Sergey-V-Z/Ethernet_Power_Load_Controller/Documentations/DG1_LEG.jpg

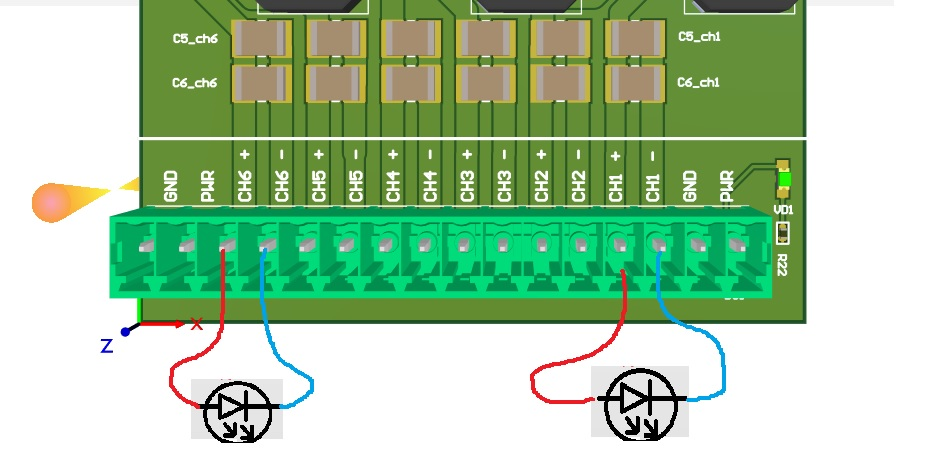
Documentations/DG1_LEG.jpg
