Sergey-V-Z/Ethernet_Power_Load_Controller/PCB/control_PWR_PCB/control_PWR_PCB.pdf

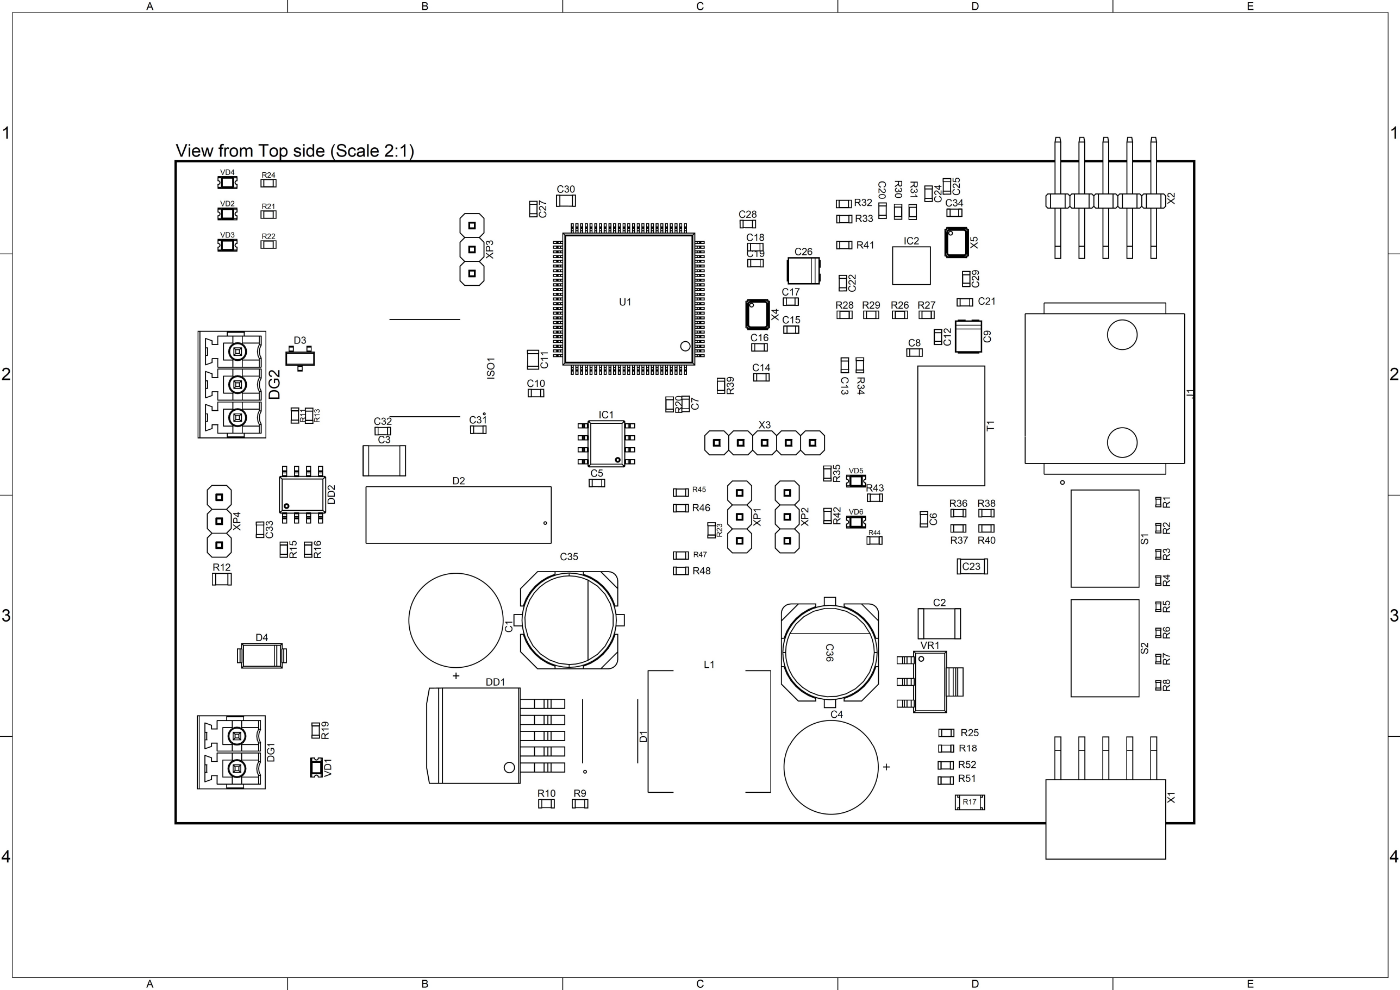
[picture p8: page 1]
