Sergey-V-Z/Ethernet_Power_Load_Controller/PCB/driverPCB/asembl.pdf

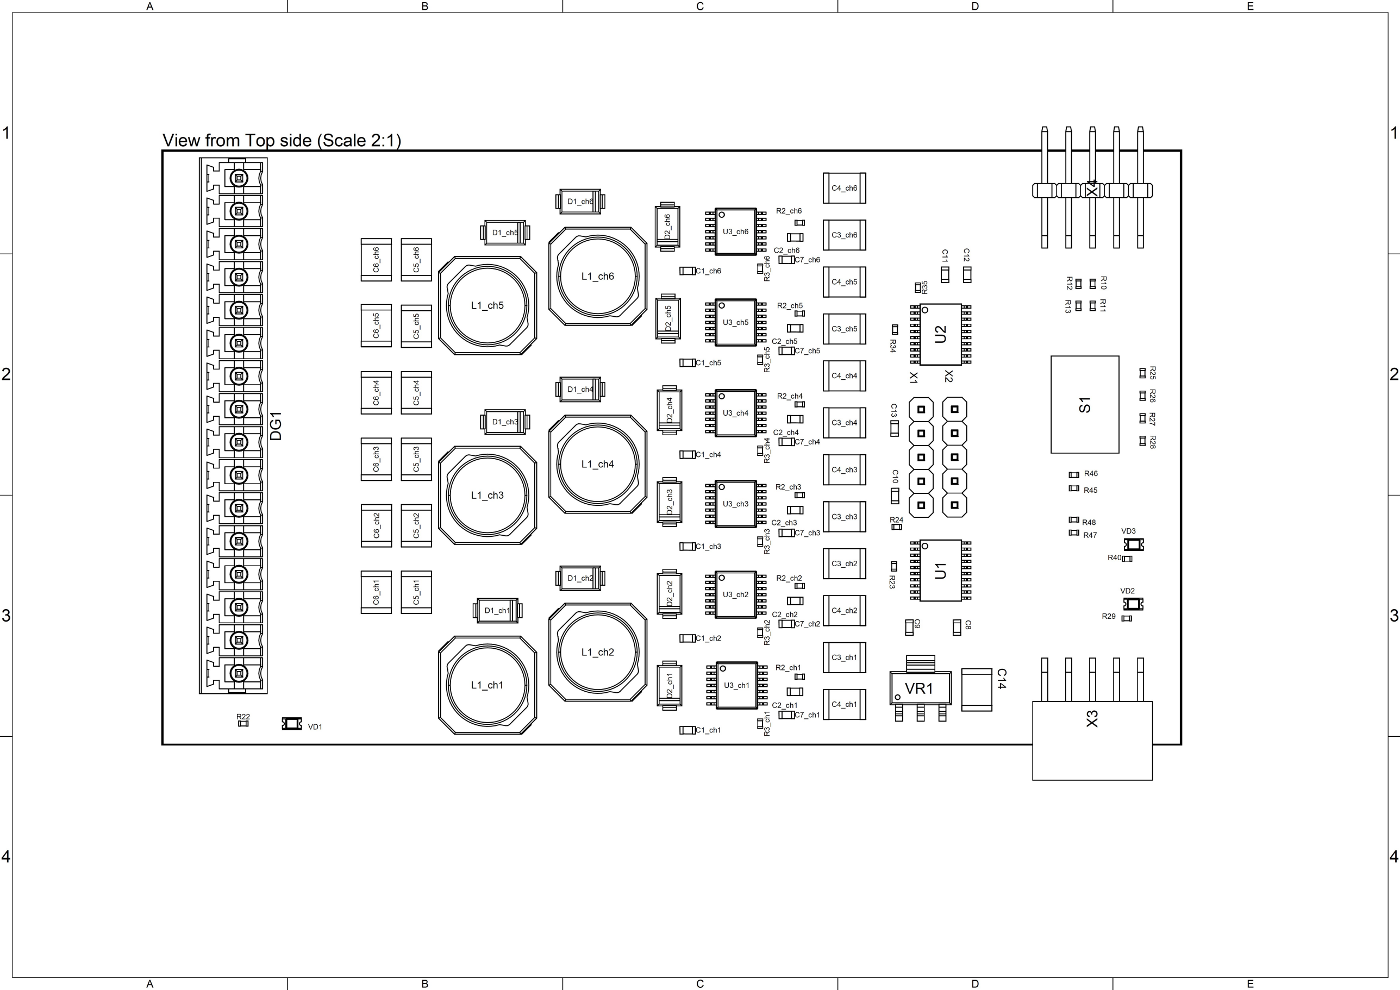
[picture p9: page 1]
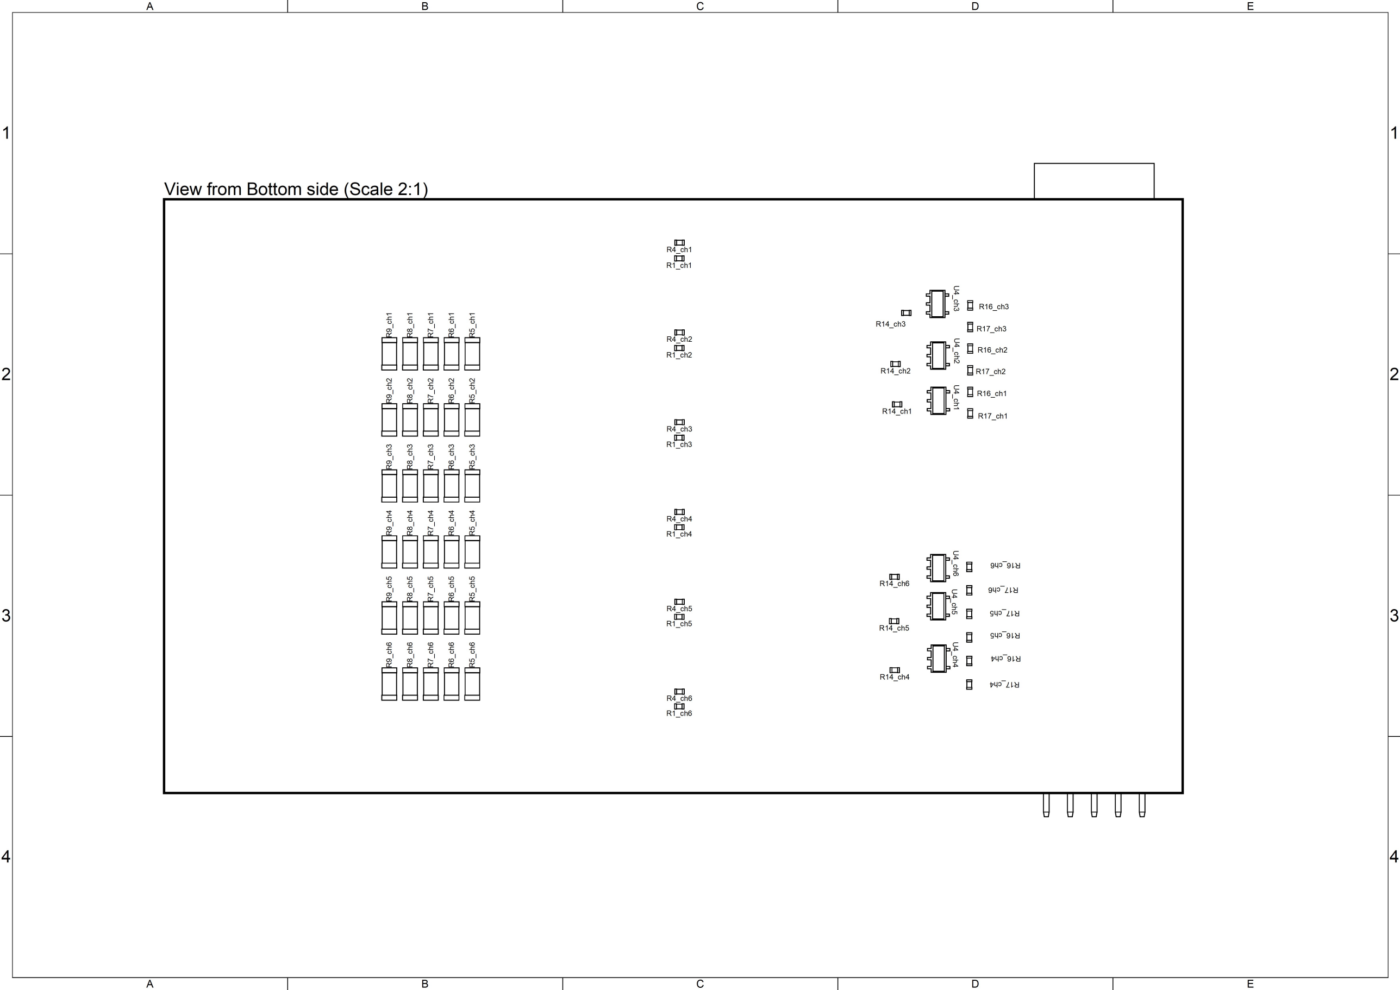
[picture p10: page 2]
