Sergey-V-Z/Ethernet_Power_Load_Controller/Documentations/Adres_Driver_LED.jpg

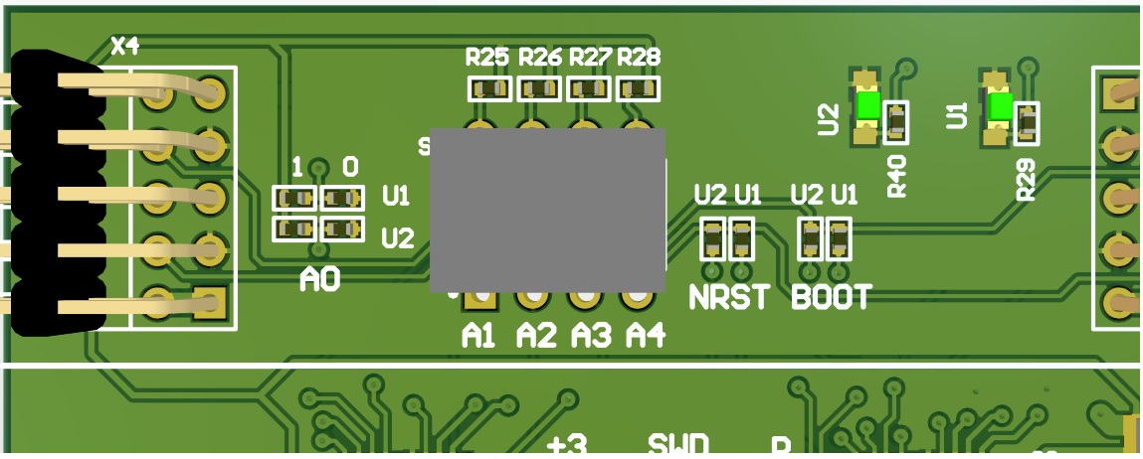
Documentations/Adres_Driver_LED.jpg
