Sergey-V-Z/Ethernet_Power_Load_Controller/Documentations/calc_1.jpg

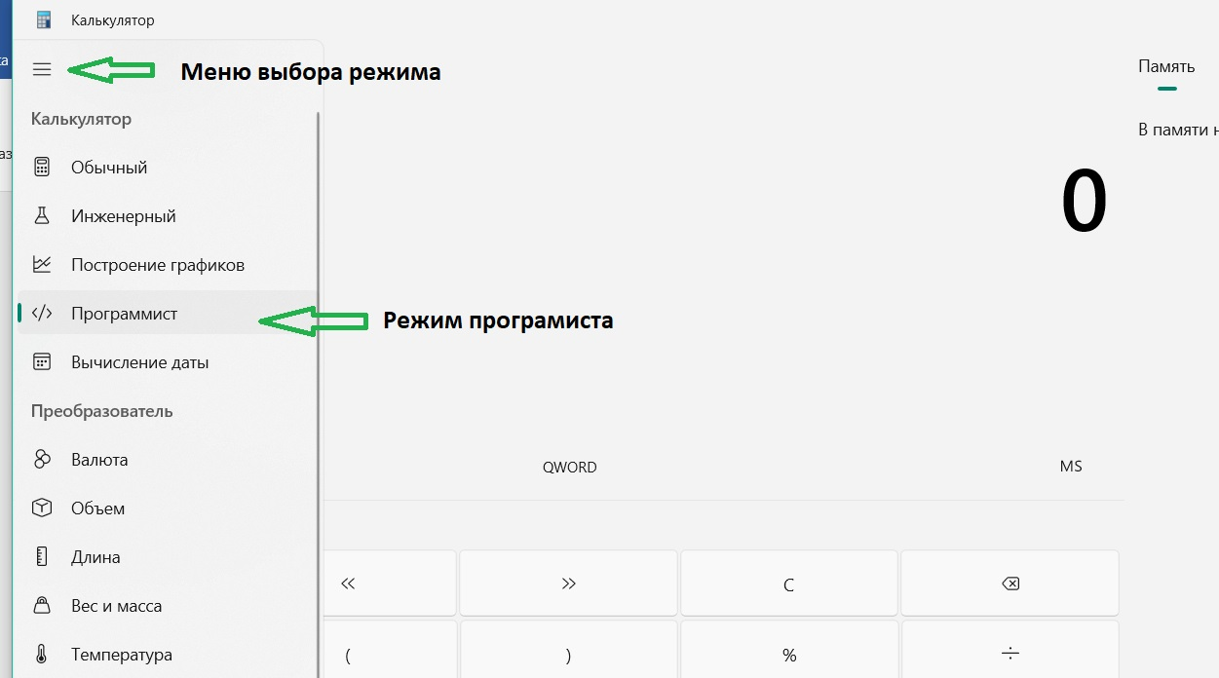
Documentations/calc_1.jpg
