Sergey-V-Z/Ethernet_Power_Load_Controller/Documentations/calc_2.jpg

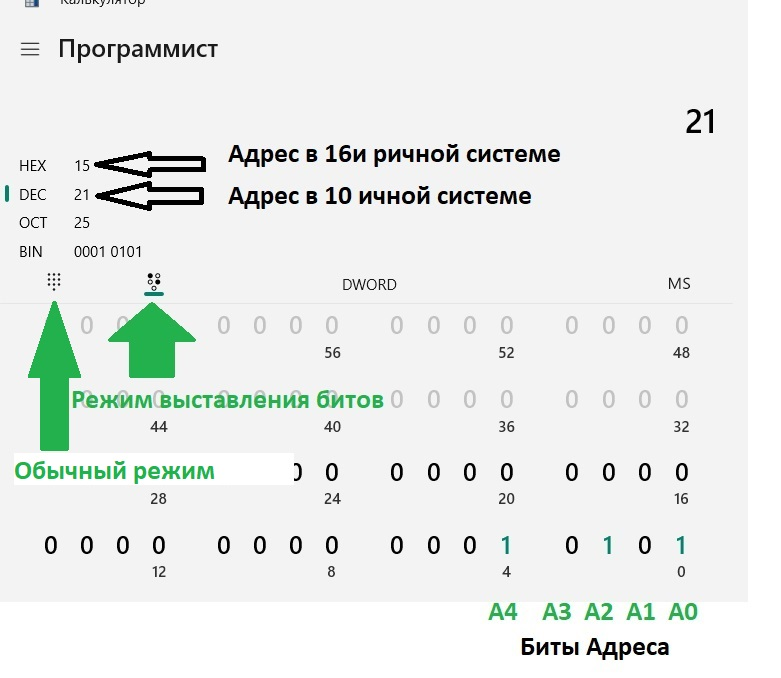
Documentations/calc_2.jpg
