Sergey-V-Z/Ethernet_Power_Load_Controller/Documentations/PWR_LOAD_v1.jpg

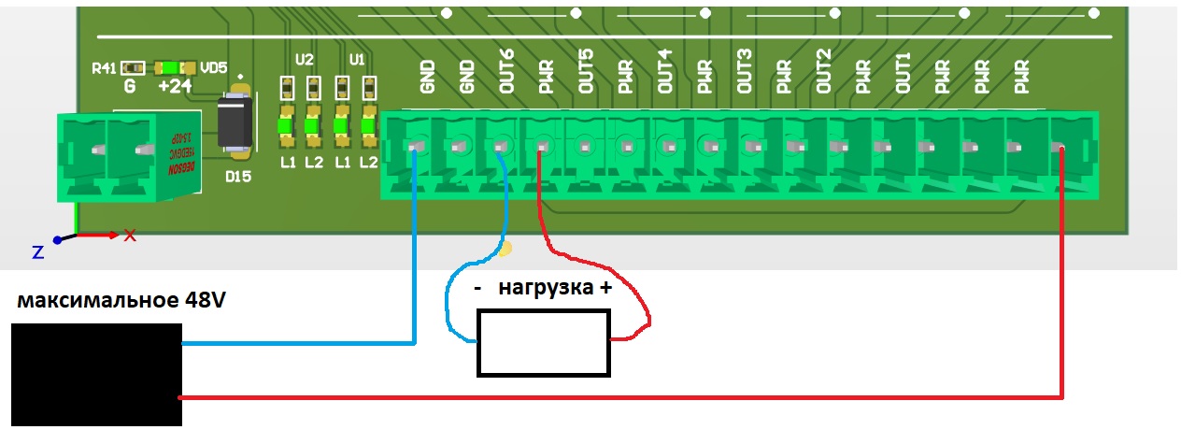
Documentations/PWR_LOAD_v1.jpg
