Sergey-V-Z/Ethernet_Power_Load_Controller/Documentations/PWR_LOAD_v3.jpg

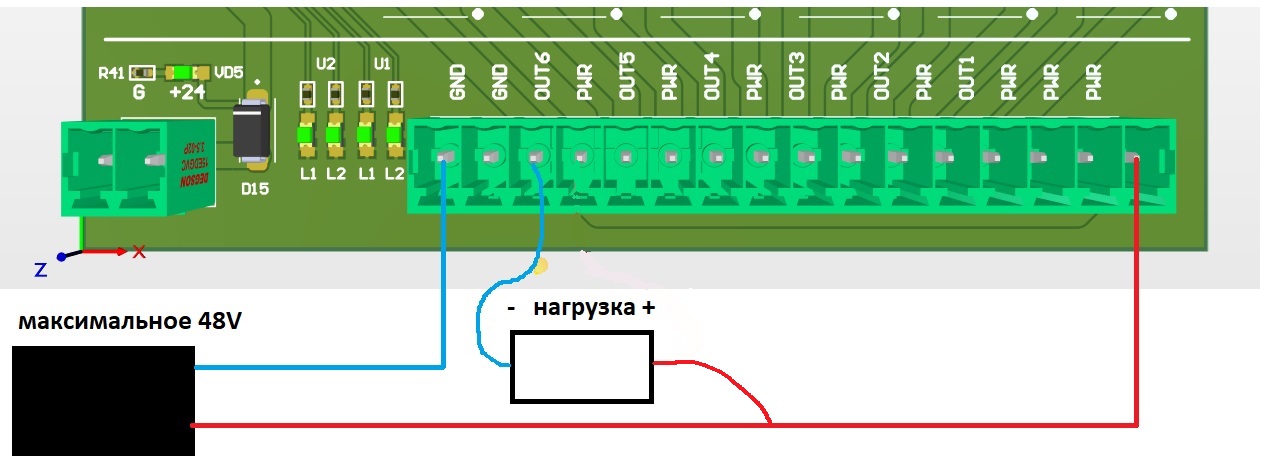
Documentations/PWR_LOAD_v3.jpg
