Sergey-V-Z/Ethernet_Power_Load_Controller/Documentations/документация для json/mermaid-diagram-2024-11-08-113011.png

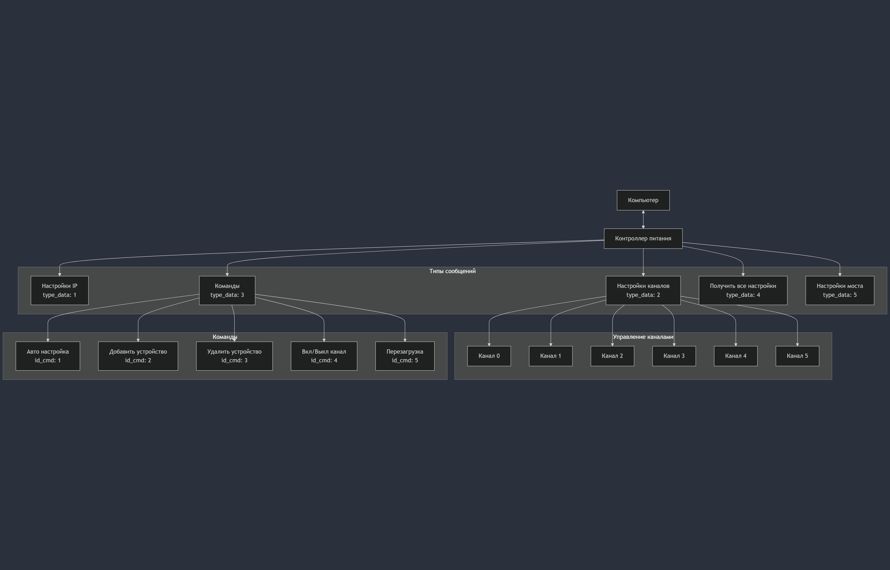
Documentations/документация для json/mermaid-diagram-2024-11-08-113011.png
