Sergey-V-Z/Ethernet_Power_Load_Controller/PCB/PWR_Switch_PCB/errors/pin6 cut.jpg

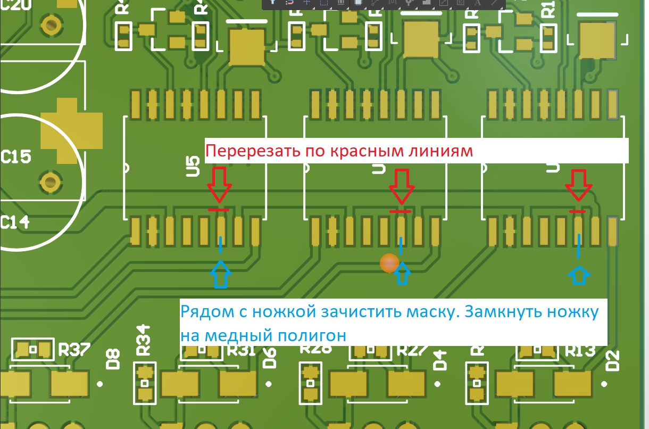
PCB/PWR_Switch_PCB/errors/pin6 cut.jpg
