Sergey-V-Z/Ethernet_Power_Load_Controller/PCB/PWR_Switch_PCB/errors/резисторы диодов и развернуть диод.jpg

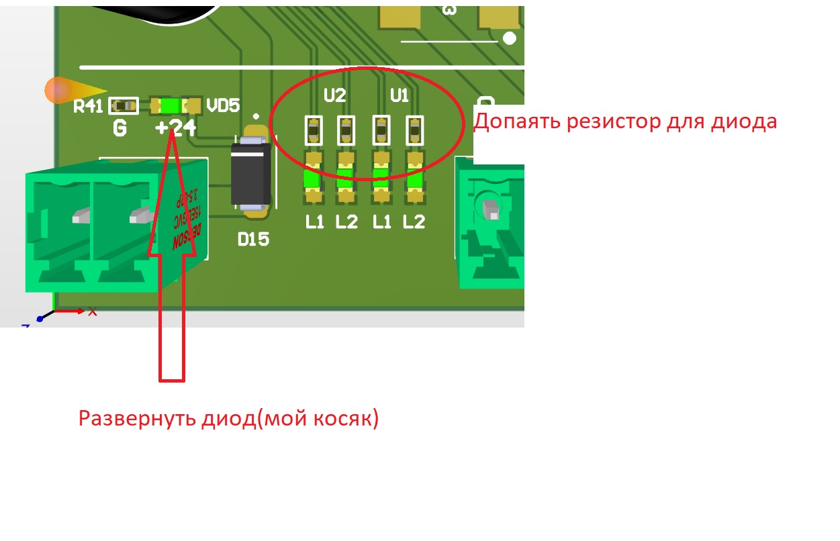
PCB/PWR_Switch_PCB/errors/резисторы диодов и развернуть диод.jpg
