Sergey-V-Z/Ethernet_Power_Load_Controller/PCB/PWR_Switch_PCB/errors/Что должно получится.jpg

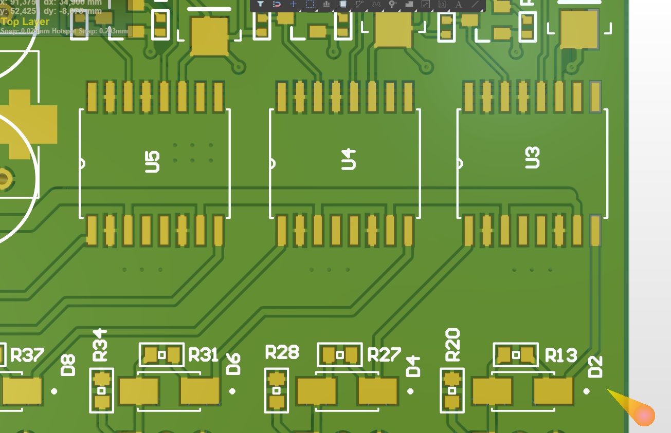
PCB/PWR_Switch_PCB/errors/Что должно получится.jpg
