Sergey-V-Z/Ethernet_Power_Load_Controller/PCB/driverPCB/Project Outputs for DriverPCB/BOM/Bill of Materials-DriverPCB.xlsx

Designator | Description | Package | Value | Quantity
X4 | Header, 5-Pin, Dual row | PLD-10R | KLS1-207-2-10-R1 | 1
X3 | Header, 5-Pin, Dual row | PBD-10R | KLS1-208-2-10-R | 1
X1, X2 | Header, 5-Pin | 2.54 x 5 |  | 2
VR1 | 800-mA 15-V linear voltage regulator | SOT-223-4 Texas Instruments | LM1117MPX-3.3 | 1
VD1, VD2, VD3 | Green | 0805 | 0805 G | 3
U4_ch1, U4_ch2, U4_ch3, U4_ch4, U4_ch5, U4_ch6 |  |  | LMC7110BIM5 | 6
U3_ch1, U3_ch2, U3_ch3, U3_ch4, U3_ch5, U3_ch6 | Constant Current Buck Regulator | None | LM3406MH | 6
U1, U2 | MCU 32-bit STM32F ARM Cortex M0 RISC 16KB Flash 2.5V/3.3V 20-Pin TSSOP Tray | None | STM32F030F4P6 | 2
S1 | DIP Switch |  | DIP4 | 1
R29, R40 | Resistor | 0402 | 0402 3K | 2
R28 | Resistor | 0402 | 04021K | 1
R10, R13, R45, R46, R47, R48 | Resistor | 0402 | 0402 NC | 6
R6_ch1, R6_ch2, R6_ch3, R6_ch4, R6_ch5, R6_ch6, R7_ch1, R7_ch2, R7_ch3, R7_ch4, R7_ch5, R7_ch6, R8_ch1, R8_ch2, R8_ch3, R8_ch4, R8_ch5, R8_ch6 | Resistor | 1206 | 1206 1 Om | 18
R5_ch1, R5_ch2, R5_ch3, R5_ch4, R5_ch5, R5_ch6, R9_ch1, R9_ch2, R9_ch3, R9_ch4, R9_ch5, R9_ch6 | Resistor | 1206 | 1206 NC | 12
R3_ch1, R3_ch2, R3_ch3, R3_ch4, R3_ch5, R3_ch6, R11, R12, R17_ch1, R17_ch2, R17_ch3, R17_ch4, R17_ch5, R17_ch6, R22, R24, R35 | Resistor | 0402 | 0402 10K | 17
R2_ch1, R2_ch2, R2_ch3, R2_ch4, R2_ch5, R2_ch6, R23, R34 | Resistor | 0402 | 0402 100K | 8
R1_ch1, R1_ch2, R1_ch3, R1_ch4, R1_ch5, R1_ch6, R4_ch1, R4_ch2, R4_ch3, R4_ch4, R4_ch5, R4_ch6, R14_ch1, R14_ch2, R14_ch3, R14_ch4, R14_ch5, R14_ch6, R16_ch1, R16_ch2, R16_ch3, R16_ch4, R16_ch5, R16_ch6, R25, R26, R27 | Resistor | 0402 | 0402 1K | 27
L1_ch1, L1_ch2, L1_ch3, L1_ch4, L1_ch5, L1_ch6 |  | None | B82464G4223M000 | 6
DG1 |  |  | NC | 1
D1_ch1, D1_ch2, D1_ch3, D1_ch4, D1_ch5, D1_ch6, D2_ch1, D2_ch2, D2_ch3, D2_ch4, D2_ch5, D2_ch6 | Diode Schottky 40 V 3A Surface Mount SMA | DO-214 Diodes Inc. | B340A-13 | 12
C3_ch1, C3_ch2, C3_ch3, C3_ch4, C3_ch5, C3_ch6, C4_ch1, C4_ch2, C4_ch3, C4_ch4, C4_ch5, C4_ch6, C5_ch1, C5_ch2, C5_ch3, C5_ch4, C5_ch5, C5_ch6, C6_ch1, C6_ch2, C6_ch3, C6_ch4, C6_ch5, C6_ch6, C14 | Ceramic Capacitor SMD, Ceramic Capacitor | 1812 | 1812 4.7 uF | 25
C2_ch1, C2_ch2, C2_ch3, C2_ch4, C2_ch5, C2_ch6 | Ceramic Capacitor SMD | 0603 | 0603 1 uF | 6
C1_ch1, C1_ch2, C1_ch3, C1_ch4, C1_ch5, C1_ch6, C7_ch1, C7_ch2, C7_ch3, C7_ch4, C7_ch5, C7_ch6, C8, C9, C10, C11, C12, C13 | Ceramic Capacitor SMD, Ceramic Capacitor | 0603 | 0603 0.1 uF | 18
