Sergey-V-Z/Ethernet_Power_Load_Controller/PCB/control_PWR_PCB/Project Outputs for control_PWR_PCB/BOM/Bill of Materials-control_PWR_PCB.xlsx

Comment | Designator | Description | Value | Quantity
PLS-3 2.54 | XP2, XP4 | Ter120, Connector, 3-Pin | PLS-3 2.54 | 2
NC | XP1, XP3 | [NoValue], Ter120 | NC | 2
25Mhz | X5 | 3.3_2.5 25Mhz | 3.3_2.5 25Mhz | 1
12Mhz | X4 | 3.3_2.5 12Mhz | 3.3_2.5 12Mhz | 1
PLS-5 2.54 | X3 | Header, 5-Pin | PLS-5 2.54 | 1
PLD-10R | X2 | Header, 5-Pin, Dual row | NC | 1
PBD-10R | X1 | Header, 5-Pin, Dual row | KLS1-208-2-10-R | 1
LM1117MPX-3.3 | VR1 | 800-mA 3.3-V linear voltage regulator | LM1117MPX-3.3 | 1
0805 Green | VD1, VD2, VD3, VD4, VD5, VD6 | 0805 Green | 0805 Green | 6
STM32F407VE | U1 | STM32F407VE Microcontroller IC 32-Bit 100-LQFP (14x14) | STM32F407VE | 1
B78476A8065A003 | T1 | Magnetics Modules for LAN Application, 10/100 Base-T Magnetics Module, 1 Port, 0 to 70 degC, 16-Pin SMD, RoHS, Tape and Reel | B78476A8065A003 | 1
SW-DIP4 | S1, S2 | DIP Switch | SW-DIP4 | 2
0603 NC | R43, R44, R46, R48 | Resistor | 0603 NC | 4
0603 75R | R36, R37, R38, R40 | Resistor | 0603 75R | 4
0603 220 Om | R35, R42 | Resistor | 0603 220 Om | 2
0603 12.1k | R34 | Resistor | 0603 12.1k | 1
0603 33R | R30, R31, R33, R41, R51, R52 | Resistor | 0603 33R | 6
0603 50R | R26, R27, R28, R29 | Resistor | 0603 50R | 4
0603 3K | R21, R22, R24 | Resistor | 0603 3K | 3
0603 510R | R20, R39 | Resistor | 0603 510R | 2
0603 4.7k | R18, R25 | Resistor | 0603 4.7k | 2
0603 0 | R17 | Resistor | 0603 0 | 1
0603 10k | R15, R16, R19, R32 | Resistor | 0603 10k | 4
0603 NC | R14 | Resistor | 0603 NC | 1
0603 120R | R12 | Resistor | 0603 120R | 1
0603 0 | R11, R13, R23, R45, R47 | Resistor | 0603 0 | 5
0603 1k | R10 | Resistor | 0603 1k | 1
0603 3k | R9 | Resistor | 0603 3k | 1
0402 10K | R1, R2, R3, R4, R5, R6, R7, R8 | Resistor | 0402 10K | 8
SRR1208-680Y | L1 | 68µH Shielded Wirewound Inductor 1.8A 18mOhm Max Nonstandard | SRR1208-680Y | 1
5520259-4 | J1 | Jack Modular Connector 8p8c _RJ45, Ethernet_ Vertical Unshielded Cat3 | 5520259-4 | 1
ISO7341 | ISO1 | Digital isolator | ISO7341 | 1
LAN8742A-CZ-TR | IC2 |  | LAN8742A-CZ-TR | 1
25Q16 or 25Q32 | IC1 | Serial Flash Memory with uniform 4KB sectors and Dual/Quad SPI and QPI | 25Q16 or 25Q32 | 1
15EDGVC-3.5-2P | DG1, DG2 |  | 15EDGVC-3.5-2P | 2
NSO8 MAX485 | DD2 | Low-Power, Slew-Rate-Limited RS-485/RS-422 Transceiver | NSO8 MAX485 | 1
LM2596S-ADJ | DD1 | SIMPLE SWITCHER® Power Converter 150 KHz 3A Step-Down Voltage Regulator, 5-pin TO-263 | LM2596S-ADJ | 1
B340A-13 | D4 | Diode Schottky 40 V 3A Surface Mount SMA | B340A-13 | 1
SM712 | D3 | Asymmetrical TVS Diode for Extended Common-Mode RS-485 | SM712 | 1
AM1DS-0505SJZ | D2 | DC-DC 5V | AM1DS-0505SJZ | 1
MBRS540T3G | D1 | Diode Schottky 40V 5A Surface Mount SMC | MBRS540T3G | 1
EEEFK1V471SV | C35, C36 | 470µF 35V Aluminum Electrolytic Capacitors Radial, Can - SMD 80mOhm @ 100kHz 2000 Hrs @ 105°C | EEEFK1V471SV | 2
0603 18 pF | C29, C34 | Ceramic Capacitor SMD C0603 | 0603 18 pF | 2
0603 1uF | C25 | Ceramic Capacitor SMD | 0603 1uF | 1
1206 1000p 2kv | C23 | Ceramic Capacitor SMD | 1206 1000p 2kv | 1
0603 18 пФ | C15, C17 | Ceramic Capacitor SMD 0603 | 0603 18 пФ | 2
0603 0.1uF | C12, C13 | Ceramic Capacitor SMD C0603 | 0603 0.1uF | 2
0805 2.2uF | C11, C30 | Ceramic Capacitor SMD | 0805 2.2uF | 2
TECAP B 10u 16V | C9, C26 | Solid Tantalum Surface Mount Capacitors | TECAP B 10u 16V | 2
0603 0.1uF | C5, C6, C7, C8, C10, C14, C16, C18, C19, C20, C21, C22, C24, C27, C28, C31, C32, C33 | Ceramic Capacitor SMD | 0603 0.1uF | 18
1812 4.7 uF | C2, C3 | Ceramic Capacitor SMD | 1812 4.7 uF | 2
10x13 NC | C1, C4 | Polarized Capacitor (Rad) | 10x13 NC | 2
