Sergey-V-Z/Ethernet_Power_Load_Controller/PCB/PWR_Switch_PCB/Project Outputs for PWR_Switch_PCB/BOM/Bill of Materials-PWR_Switch_PCB.xlsx

Comment | Description | Designator | Footprint | LibRef | Quantity
0603 0.1 uF | Ceramic Capacitor | C1, C2, C3, C4, C5, C6 | CAPACITOR 0603 | Capasitor | 6
22uf 35V | Tantal TypeD HGD226K035T | C8, C10, C17 | C - EL_Tantal_TYPED | C - EL_Tantal_SMD_TypeD | 3
18112 4.7 uF | Ceramic Capacitor | C11 | CAPCHIP1812 | Cap C | 1
470µF 35V | EEEFK1V471SV 470µF 35V Aluminum Electrolytic Capacitors Radial, Can - SMD 80mOhm @ 100kHz 2000 Hrs @ 105°C | C12, C15, C19, C21 | CAP_EEEFK1V471SV | EEEFK1V471SV | 4
NC | Polarized Capacitor (Rad) 220uF 50v | C13, C14, C18, C20 | ECR 10x13mm | Cap Pol | 4
MBRS540T3G | Diode Schottky 40V 5A Surface Mount SMC | D1, D3, D5, D7, D9, D10, D12, D13 | DIOM7958X213N | MBRS540T3G | 8
SMA-2 ES1J | Diode Standard 600V 1A Surface Mount SMA (DO-214AC) | D2, D4, D6, D8, D11, D14 | DIO_ES1J | ES1J | 6
B340A-13 | Diode Schottky 40 V 3A Surface Mount SMA | D15 | DIOM5226X240N | B340A-13 | 1
LM2596S-ADJ | SIMPLE SWITCHER® Power Converter 150 KHz 3A Step-Down Voltage Regulator, 5-pin TO-263 | DD1, DD2 | TO-263 | LM2596S-ADJ | 2
15EDGVC-3.5-2P | 15EDGVC-3.5-2P | DG1 | 15EDGVC-3.5-16P | 15EDGVC-3.5-2P | 1
15EDGVC-3.5-16P | 15EDGVC-3.5-16P | DG2 | 15EDGVC-3.5-16P | 15EDGVC-3.5-16P | 1
SRR1208-680Y | 68µH Shielded Wirewound Inductor 1.8A 18mOhm Max Nonstandard | L1, L2 | SRR1208 | SRR1208-6R5ML | 2
IRFB7730 | N-Channel Power Transistor - TO-220 | Q1, Q2, Q3, Q4, Q5, Q6 | up-miror | IRF | 6
0402 10K | Resistor | R1, R2, R3, R4, R6, R8, R18, R19, R25, R26, R32, R33, R35, R36, R41, R43, R44, R48, R49, R50, R51, R53 | Resistor 0402 | Resistor | 22
NC | Resistor | R5, R7, R29, R30, R56, R57 | Resistor 0402 | Resistor | 6
0402 3K | Resistor | R9, R10, R11, R12, R54 | Resistor 0402 | Resistor | 5
0603 33R | Resistor | R13, R27, R31, R37, R42, R52 | Resistor 0603 | Resistor | 6
0402 1K | Resistor | R14, R15, R16, R17 | Resistor 0402 | Resistor | 4
0603 1,5k | Resistor | R20, R28, R34, R38, R45, R55 | Resistor 0603 | Resistor | 6
0603 9.1k | Resistor | R39 | Resistor 0603 | Resistor | 1
0603 1k | Resistor | R40, R47 | Resistor 0603 | Resistor | 2
0603 3k | Resistor | R46 | Resistor 0603 | Resistor | 1
SW-DIP4 | DIP Switch | S1 | DIP-8 | SW-DIP4 | 1
STM32F030F4P6 | MCU 32-bit STM32F ARM Cortex M0 RISC 16KB Flash 2.5V/3.3V 20-Pin TSSOP Tray | U1, U2 | SOP65P640X120-20N | STM32F030F4P6 | 2
IR2110S | Half-Bridge Gate Driver IC Non-Inverting 16-SOIC | U3, U4, U5 | SOIC127P1032X265-16N | IR2110S | 3
0805 G | Green | VD1, VD2, VD3, VD4, VD5 | 0805- | LED SMD | 5
LM1117MPX-3.3 | 800-mA 3.3-V linear voltage regulator | VR1 | VREG_LM1117MPX-3.3 | LM1117MPX-3.3 | 1
sot23 BSS138 | N-Channel Power MOSFET | VT1, VT2, VT3, VT4, VT5, VT6 | SOT23 | BSS138 | 6
PLS-5 2.54 | Header, 5-Pin | X1, X2 | PLS-5-3D | PLS-5 | 2
PBD-10R | Header, 5-Pin, Dual row | X3 | PBD-10RR | PBD-10R | 1
PLD-10R | Header, 5-Pin, Dual row | X4 | PLD-10RR2 | PLD-10R | 1
