Sergey-V-Z/Ethernet_Power_Load_Controller/PCB/driverPCB/Bill of Materials-DriverPCB.xlsx

Designator | Package | Value | Quantity
X4 | PLD-10R |  | 1
X3 | PBD-10R |  | 1
X1, X2 | 2.54 x 5 |  | 2
VT1_ch1, VT1_ch2, VT1_ch3, VT1_ch4, VT1_ch5, VT1_ch6 | SOT-23 | BC846 | 6
VR1 | SOT-223-4 Texas Instruments | LM1117MPX-3.3 | 1
VD2, VD3 | 0805 | 0805 | 2
VD1 | 0805 | 0805 | 1
U3, U4 | None | STM32F030F4P6 | 2
U2_ch1, U2_ch2, U2_ch3, U2_ch4, U2_ch5, U2_ch6 |  | LMC7110BIM5 | 6
U1_ch1, U1_ch2, U1_ch3, U1_ch4, U1_ch5, U1_ch6 | None | LM3406MH | 6
S1, S2 |  | DIP4 | 2
R30, R31, R32, R33, R41, R42, R43, R44 | 0402 | 4.7K | 8
R20, R21, R29, R40 | 0402 | 3K | 4
R11_ch1, R11_ch2, R11_ch3, R11_ch4, R11_ch5, R11_ch6 | 0402 | 100 | 6
R10_ch1, R10_ch2, R10_ch3, R10_ch4, R10_ch5, R10_ch6 | 0402 | NC | 6
R7_ch1, R7_ch2, R7_ch3, R7_ch4, R7_ch5, R7_ch6, R8_ch1, R8_ch2, R8_ch3, R8_ch4, R8_ch5, R8_ch6, R9_ch1, R9_ch2, R9_ch3, R9_ch4, R9_ch5, R9_ch6 | 1206 | 1 | 18
R5_ch1, R5_ch2, R5_ch3, R5_ch4, R5_ch5, R5_ch6, R6_ch1, R6_ch2, R6_ch3, R6_ch4, R6_ch5, R6_ch6 | 1206 | NC | 12
R3_ch1, R3_ch2, R3_ch3, R3_ch4, R3_ch5, R3_ch6, R15_ch1, R15_ch2, R15_ch3, R15_ch4, R15_ch5, R15_ch6, R17_ch1, R17_ch2, R17_ch3, R17_ch4, R17_ch5, R17_ch6, R22, R23, R24, R34, R35 | 0402 | 10K | 23
R2_ch1, R2_ch2, R2_ch3, R2_ch4, R2_ch5, R2_ch6, R13_ch1, R13_ch2, R13_ch3, R13_ch4, R13_ch5, R13_ch6, R18 | 0402 | 100K | 13
R1_ch1, R1_ch2, R1_ch3, R1_ch4, R1_ch5, R1_ch6, R4_ch1, R4_ch2, R4_ch3, R4_ch4, R4_ch5, R4_ch6, R12_ch1, R12_ch2, R12_ch3, R12_ch4, R12_ch5, R12_ch6, R14_ch1, R14_ch2, R14_ch3, R14_ch4, R14_ch5, R14_ch6, R16_ch1, R16_ch2, R16_ch3, R16_ch4, R16_ch5, R16_ch6, R19, R25, R26, R27, R28, R36, R37, R38, R39 | 0402 | 1K | 39
Q1_ch1, Q1_ch2, Q1_ch3, Q1_ch4, Q1_ch5, Q1_ch6 | None | 2N7002 | 6
L1_ch1, L1_ch2, L1_ch3, L1_ch4, L1_ch5, L1_ch6 | None | B82464G4223M000 | 6
DG1 |  | NC | 1
D1_ch1, D1_ch2, D1_ch3, D1_ch4, D1_ch5, D1_ch6, D2_ch1, D2_ch2, D2_ch3, D2_ch4, D2_ch5, D2_ch6 | DO-214 Diodes Inc. | B340A-13 | 12
C3_ch1, C3_ch2, C3_ch3, C3_ch4, C3_ch5, C3_ch6, C4_ch1, C4_ch2, C4_ch3, C4_ch4, C4_ch5, C4_ch6, C5_ch1, C5_ch2, C5_ch3, C5_ch4, C5_ch5, C5_ch6, C6_ch1, C6_ch2, C6_ch3, C6_ch4, C6_ch5, C6_ch6, C14 | 1812 | 4.7 uF | 25
C2_ch1, C2_ch2, C2_ch3, C2_ch4, C2_ch5, C2_ch6 | 0603 | 1 uF | 6
C1_ch1, C1_ch2, C1_ch3, C1_ch4, C1_ch5, C1_ch6, C7_ch1, C7_ch2, C7_ch3, C7_ch4, C7_ch5, C7_ch6, C8, C9, C10, C11, C12, C13 | 0603 | 0.1 uF | 18
