Sergey-V-Z/Ethernet_Power_Load_Controller/PCB/driverPCB/DriverPCB.pdf

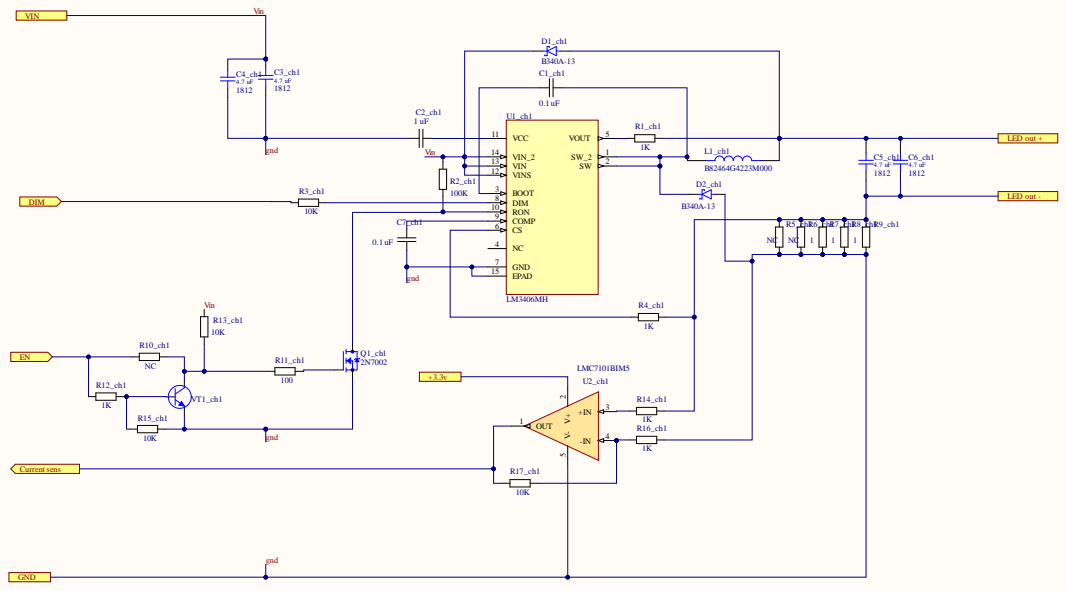
[picture p21: page 1]

VCC 11 VIN_2 14

VIN 13

RON 10

0.1 uF | | COMP 9

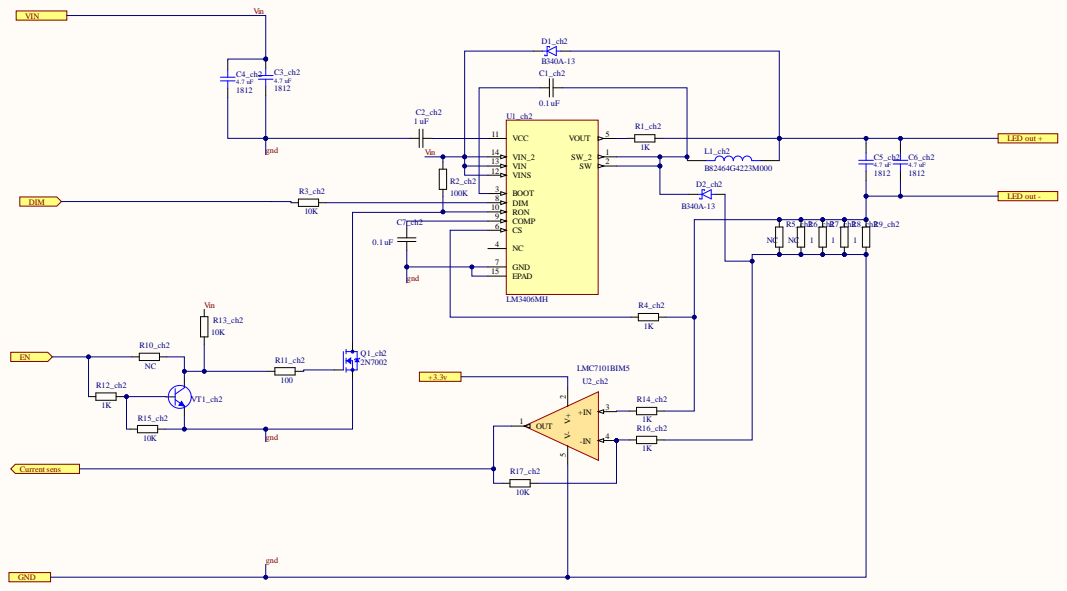
[picture p22: page 2]

VCC 11 VIN_2 14

VIN 13

RON 10

0.1 uF | | COMP 9

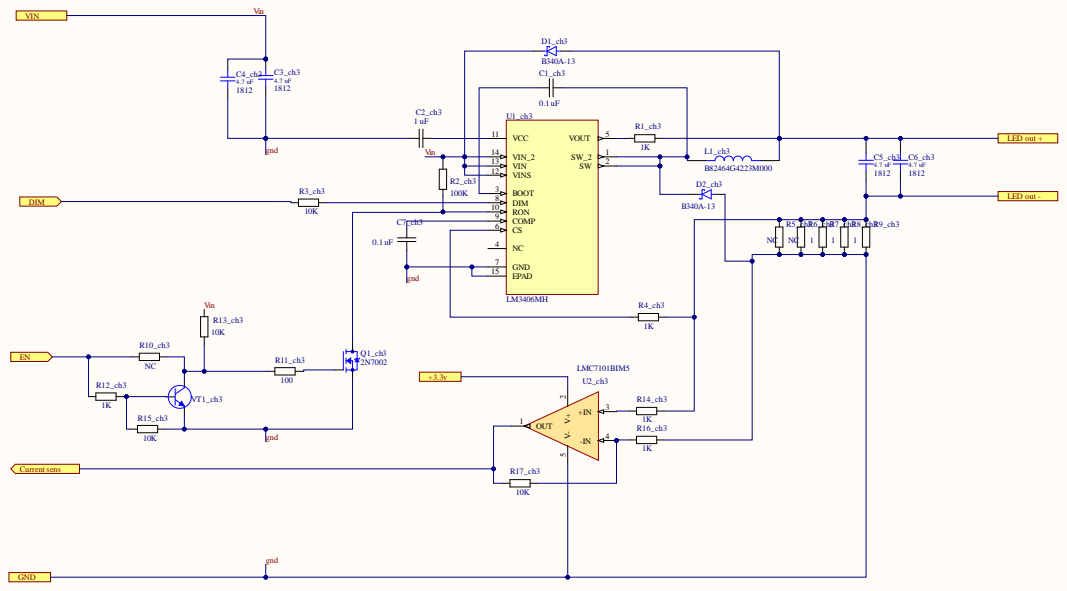
[picture p23: page 3]

VCC 11 VIN_2 14

VIN 13

RON 10

0.1 uF | | COMP 9

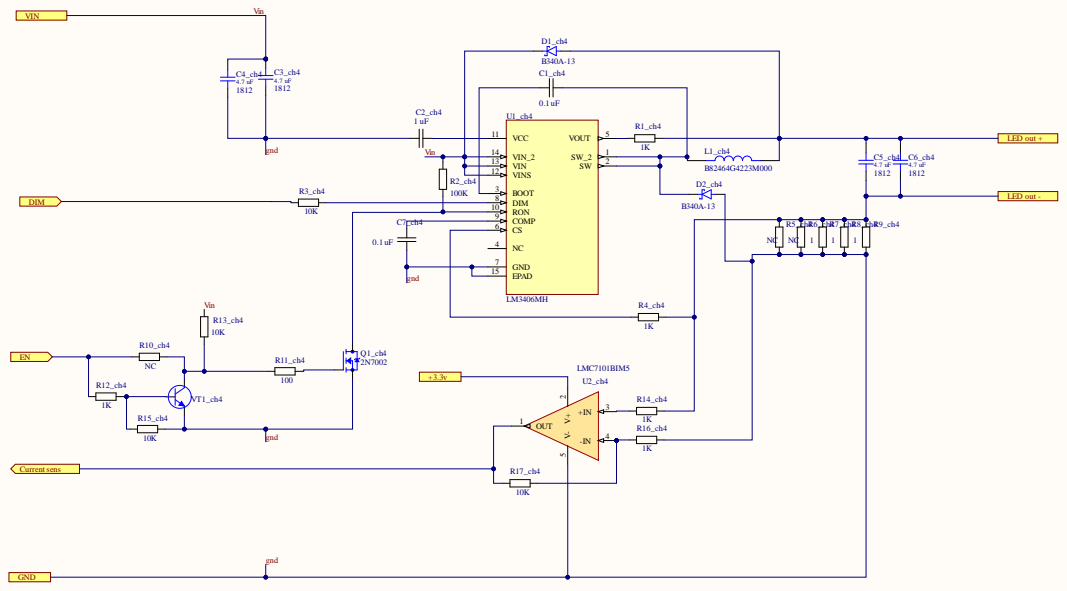
[picture p24: page 4]

VCC 11 VIN_2 14

VIN 13

RON 10

0.1 uF | | COMP 9

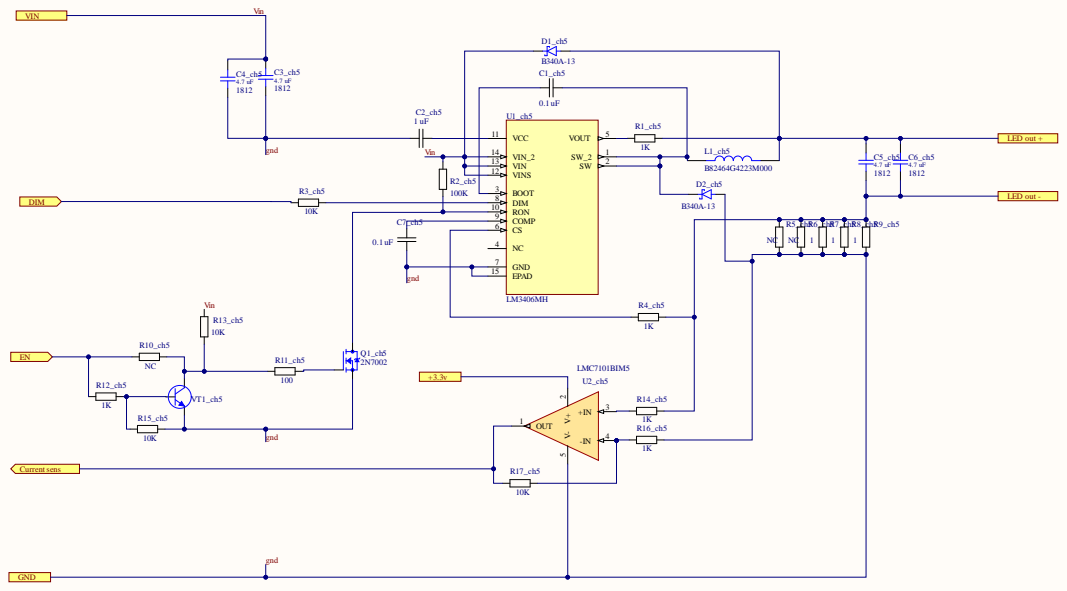
[picture p25: page 5]

VCC 11 VIN_2 14

VIN 13

RON 10

0.1 uF | | COMP 9

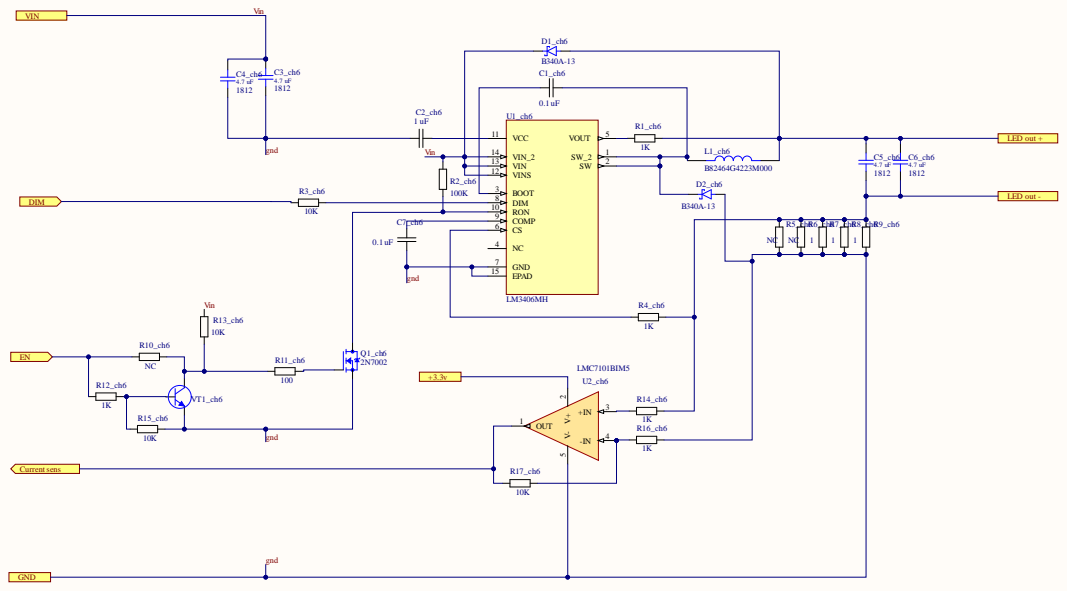
[picture p26: page 6]

VCC 11 VIN_2 14

VIN 13

RON 10

0.1 uF | | COMP 9

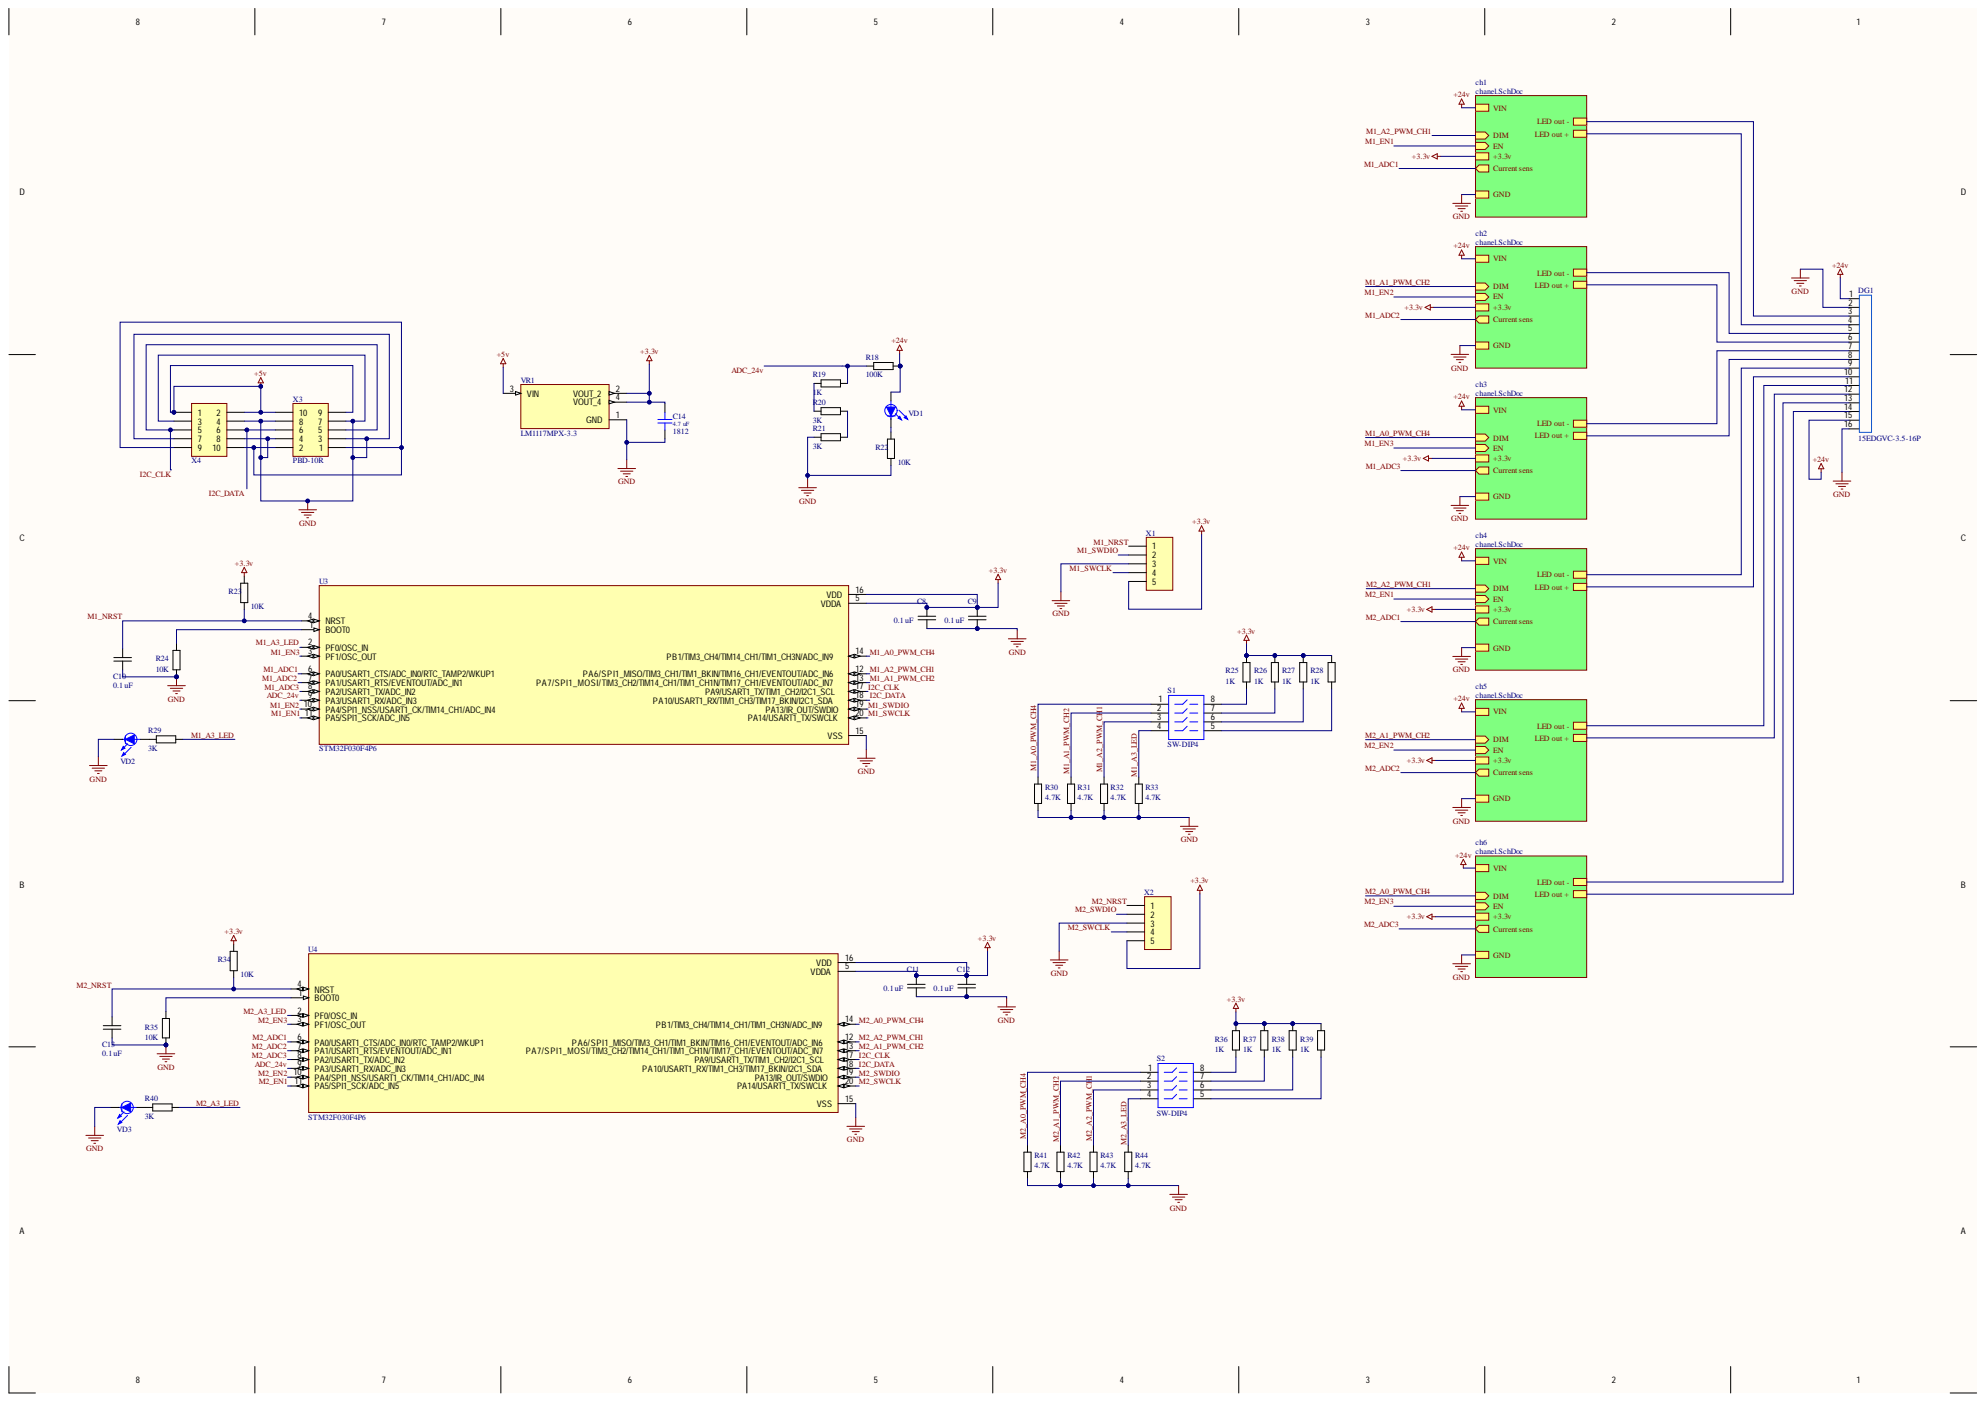
[picture p27: page 7]

VIN LED out -LED out + DIM EN +3.3v Current sens GND | 13
