Sergey-V-Z/Ethernet_Power_Load_Controller/PCB/PWR_Switch_PCB/PWR_Switch_PCB.pdf

AA

BB

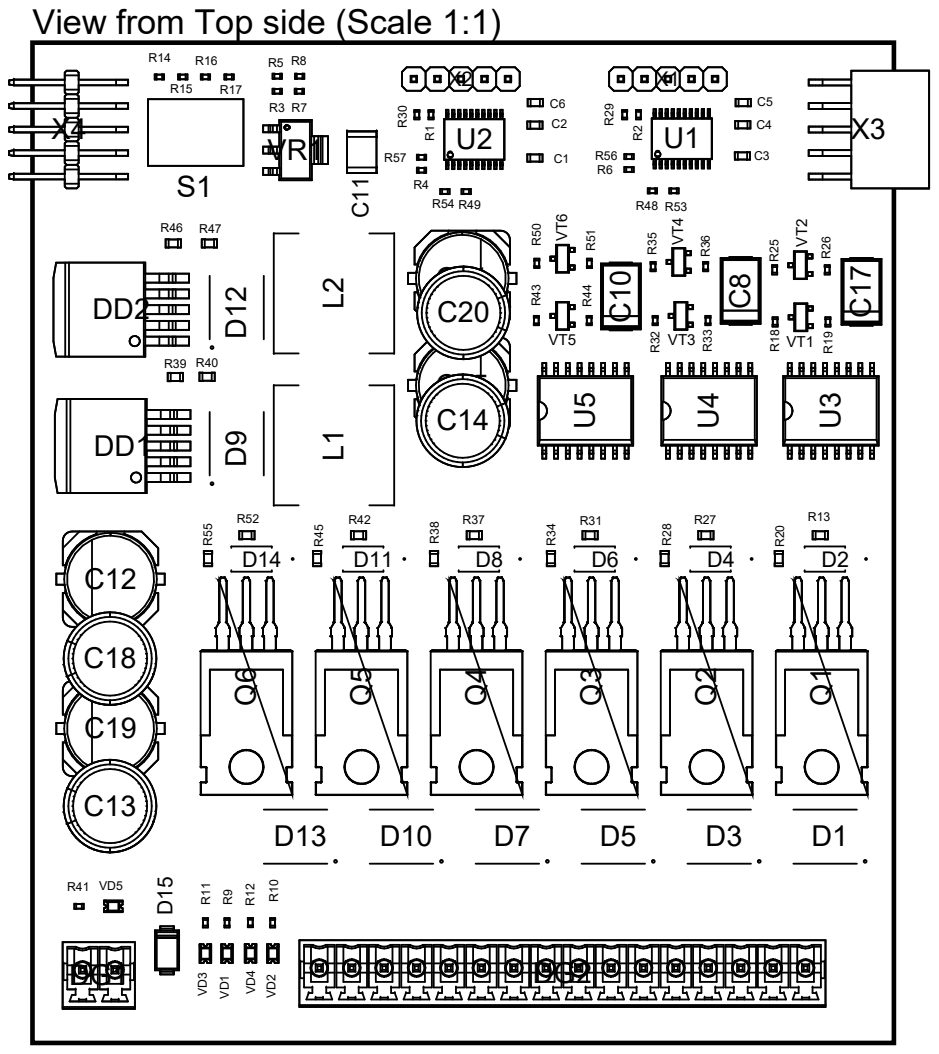
[picture p28: page 1]

View from Top side (Scale 1:1)
