Sergey-V-Z/Ethernet_Power_Load_Controller/PCB/driverPCB/drv.pdf

A

B

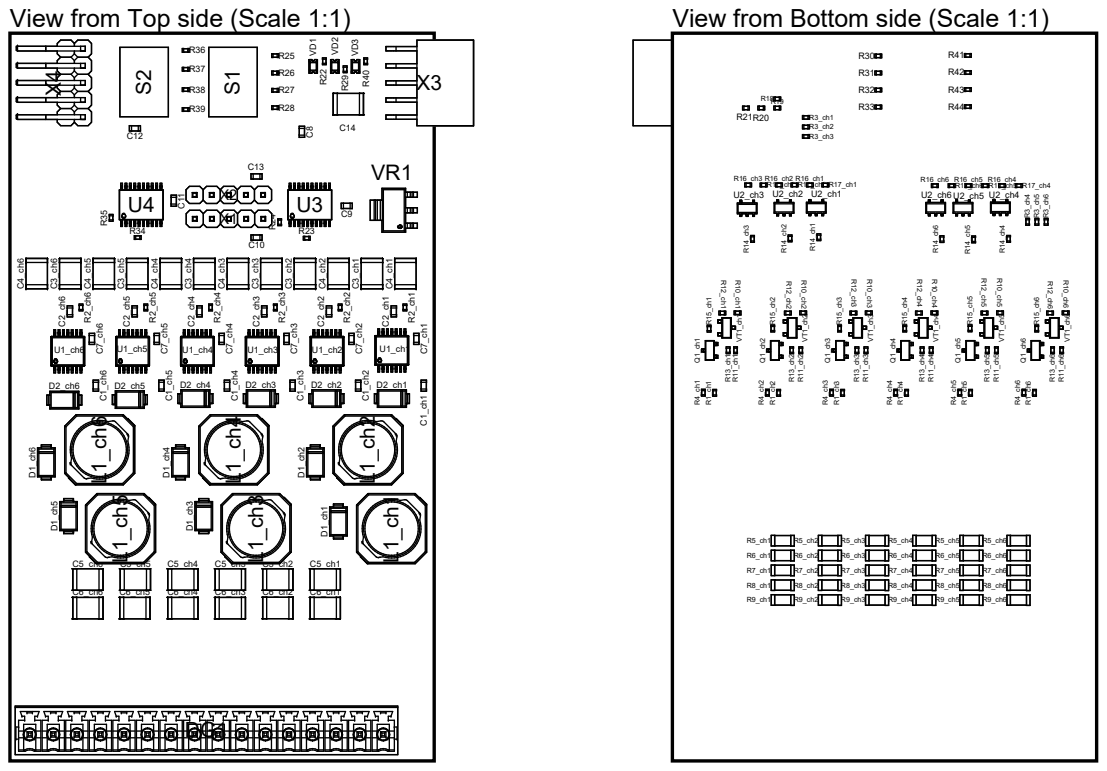
[picture p29: page 1]

View from Top side (Scale 1:1)

View from Bottom side (Scale 1:1)
