Sergey-V-Z/Ethernet_Power_Load_Controller/(list of files, drawings)

Other design files:
PCB/control_PWR_PCB/control_PWR_PCB.PrjPcb
PCB/control_PWR_PCB/control_PWR_PCB.SchDoc
PCB/driverPCB/chanel.SchDoc
PCB/driverPCB/DriverPCB.PrjPcb
PCB/driverPCB/DriverPCB.SchDoc
PCB/PWR_Switch_PCB/PWR_Switch_PCB.PrjPcb
PCB/PWR_Switch_PCB/PWR_Switch_PCB.SchDoc
