Sergey-V-Z/Ethernet_Power_Load_Controller/firmware/Contrrol/Control_PWR/Core/Inc/main.h

#define ID_STRING " Controll ver1.3"
#define START_ADR_I2C 1
#define MAX_ADR_DEV 16 // 16 with 0
#define MAX_CH_NAME MAX_ADR_DEV * 3 // 48
#define DBG_PORT huart6
#define LOG_TX_BUF_SIZE 1024*4
#define CURENT_VERSION 46
#define ID_CTRL 1
#define NAME "pwr controller"
#define LWIP_DHCP 1
#define UART6_RX_LENGTH 512
#define message_RX_LENGTH 512
#define NVS_KEY_BRIDGE "br"  // Вместо "bridge"
#define LOG_ERR "Err: "      // Вместо "Error: "
#define LOG_OK "OK"          // Вместо "Success" или "OK: "
#define MAC_IP_Pin_Pin GPIO_PIN_2
#define MAC_IP_Pin_GPIO_Port GPIOE
#define R_Pin GPIO_PIN_13
#define R_GPIO_Port GPIOC
#define G_Pin GPIO_PIN_14
#define G_GPIO_Port GPIOC
#define B_Pin GPIO_PIN_15
#define B_GPIO_Port GPIOC
#define eth_NRST_Pin GPIO_PIN_0
#define eth_NRST_GPIO_Port GPIOA
#define MAC_b0_Pin GPIO_PIN_8
#define MAC_b0_GPIO_Port GPIOD
#define MAC_b1_Pin GPIO_PIN_9
#define MAC_b1_GPIO_Port GPIOD
#define MAC_b2_Pin GPIO_PIN_10
#define MAC_b2_GPIO_Port GPIOD
#define MAC_b3_Pin GPIO_PIN_11
#define MAC_b3_GPIO_Port GPIOD
#define MAC_b4_Pin GPIO_PIN_12
#define MAC_b4_GPIO_Port GPIOD
#define MAC_b5_Pin GPIO_PIN_13
#define MAC_b5_GPIO_Port GPIOD
#define MAC_b6_Pin GPIO_PIN_14
#define MAC_b6_GPIO_Port GPIOD
#define MAC_b7_Pin GPIO_PIN_15
#define MAC_b7_GPIO_Port GPIOD
#define SPI3_CS_Pin GPIO_PIN_15
#define SPI3_CS_GPIO_Port GPIOA
#define WP_Pin GPIO_PIN_0
#define WP_GPIO_Port GPIOD
#define HOLD_Pin GPIO_PIN_1
#define HOLD_GPIO_Port GPIOD
#define DE_M_Pin GPIO_PIN_4
#define DE_M_GPIO_Port GPIOD
