Sergey-V-Z/Ethernet_Power_Load_Controller/firmware/Contrrol/Control_PWR/Core/Src/modbus_tcp_rtu.cpp

/* Includes ------------------------------------------------------------------*/
#include "FreeRTOS.h"
#include "task.h"
#include "main.h"
#include "cmsis_os.h"

static const uint8_t aucCRCHi[] = {
    0x00, 0xC1, 0x81, 0x40, 0x01, 0xC0, 0x80, 0x41, 0x01, 0xC0, 0x80, 0x41,
    0x00, 0xC1, 0x81, 0x40, 0x01, 0xC0, 0x80, 0x41, 0x00, 0xC1, 0x81, 0x40,
    0x00, 0xC1, 0x81, 0x40, 0x01, 0xC0, 0x80, 0x41, 0x01, 0xC0, 0x80, 0x41,
    0x00, 0xC1, 0x81, 0x40, 0x00, 0xC1, 0x81, 0x40, 0x01, 0xC0, 0x80, 0x41,
    0x00, 0xC1, 0x81, 0x40, 0x01, 0xC0, 0x80, 0x41, 0x01, 0xC0, 0x80, 0x41,
    0x00, 0xC1, 0x81, 0x40, 0x01, 0xC0, 0x80, 0x41, 0x00, 0xC1, 0x81, 0x40,
    0x00, 0xC1, 0x81, 0x40, 0x01, 0xC0, 0x80, 0x41, 0x00, 0xC1, 0x81, 0x40,
    0x01, 0xC0, 0x80, 0x41, 0x01, 0xC0, 0x80, 0x41, 0x00, 0xC1, 0x81, 0x40,
    0x00, 0xC1, 0x81, 0x40, 0x01, 0xC0, 0x80, 0x41, 0x01, 0xC0, 0x80, 0x41,
    0x00, 0xC1, 0x81, 0x40, 0x01, 0xC0, 0x80, 0x41, 0x00, 0xC1, 0x81, 0x40,
    0x00, 0xC1, 0x81, 0x40, 0x01, 0xC0, 0x80, 0x41, 0x01, 0xC0, 0x80, 0x41,
    0x00, 0xC1, 0x81, 0x40, 0x00, 0xC1, 0x81, 0x40, 0x01, 0xC0, 0x80, 0x41,
    0x00, 0xC1, 0x81, 0x40, 0x01, 0xC0, 0x80, 0x41, 0x01, 0xC0, 0x80, 0x41,
    0x00, 0xC1, 0x81, 0x40, 0x00, 0xC1, 0x81, 0x40, 0x01, 0xC0, 0x80, 0x41,
    0x01, 0xC0, 0x80, 0x41, 0x00, 0xC1, 0x81, 0x40, 0x01, 0xC0, 0x80, 0x41,
    0x00, 0xC1, 0x81, 0x40, 0x00, 0xC1, 0x81, 0x40, 0x01, 0xC0, 0x80, 0x41,
    0x00, 0xC1, 0x81, 0x40, 0x01, 0xC0, 0x80, 0x41, 0x01, 0xC0, 0x80, 0x41,
    0x00, 0xC1, 0x81, 0x40, 0x01, 0xC0, 0x80, 0x41, 0x00, 0xC1, 0x81, 0x40,
    0x00, 0xC1, 0x81, 0x40, 0x01, 0xC0, 0x80, 0x41, 0x01, 0xC0, 0x80, 0x41,
    0x00, 0xC1, 0x81, 0x40, 0x00, 0xC1, 0x81, 0x40, 0x01, 0xC0, 0x80, 0x41,
    0x00, 0xC1, 0x81, 0x40, 0x01, 0xC0, 0x80, 0x41, 0x01, 0xC0, 0x80, 0x41,
    0x00, 0xC1, 0x81, 0x40
};

static const uint8_t aucCRCLo[] = {
    0x00, 0xC0, 0xC1, 0x01, 0xC3, 0x03, 0x02, 0xC2, 0xC6, 0x06, 0x07, 0xC7,
    0x05, 0xC5, 0xC4, 0x04, 0xCC, 0x0C, 0x0D, 0xCD, 0x0F, 0xCF, 0xCE, 0x0E,
    0x0A, 0xCA, 0xCB, 0x0B, 0xC9, 0x09, 0x08, 0xC8, 0xD8, 0x18, 0x19, 0xD9,
    0x1B, 0xDB, 0xDA, 0x1A, 0x1E, 0xDE, 0xDF, 0x1F, 0xDD, 0x1D, 0x1C, 0xDC,
    0x14, 0xD4, 0xD5, 0x15, 0xD7, 0x17, 0x16, 0xD6, 0xD2, 0x12, 0x13, 0xD3,
    0x11, 0xD1, 0xD0, 0x10, 0xF0, 0x30, 0x31, 0xF1, 0x33, 0xF3, 0xF2, 0x32,
    0x36, 0xF6, 0xF7, 0x37, 0xF5, 0x35, 0x34, 0xF4, 0x3C, 0xFC, 0xFD, 0x3D,
    0xFF, 0x3F, 0x3E, 0xFE, 0xFA, 0x3A, 0x3B, 0xFB, 0x39, 0xF9, 0xF8, 0x38,
    0x28, 0xE8, 0xE9, 0x29, 0xEB, 0x2B, 0x2A, 0xEA, 0xEE, 0x2E, 0x2F, 0xEF,
    0x2D, 0xED, 0xEC, 0x2C, 0xE4, 0x24, 0x25, 0xE5, 0x27, 0xE7, 0xE6, 0x26,
    0x22, 0xE2, 0xE3, 0x23, 0xE1, 0x21, 0x20, 0xE0, 0xA0, 0x60, 0x61, 0xA1,
    0x63, 0xA3, 0xA2, 0x62, 0x66, 0xA6, 0xA7, 0x67, 0xA5, 0x65, 0x64, 0xA4,
    0x6C, 0xAC, 0xAD, 0x6D, 0xAF, 0x6F, 0x6E, 0xAE, 0xAA, 0x6A, 0x6B, 0xAB,
    0x69, 0xA9, 0xA8, 0x68, 0x78, 0xB8, 0xB9, 0x79, 0xBB, 0x7B, 0x7A, 0xBA,
    0xBE, 0x7E, 0x7F, 0xBF, 0x7D, 0xBD, 0xBC, 0x7C, 0xB4, 0x74, 0x75, 0xB5,
    0x77, 0xB7, 0xB6, 0x76, 0x72, 0xB2, 0xB3, 0x73, 0xB1, 0x71, 0x70, 0xB0,
    0x50, 0x90, 0x91, 0x51, 0x93, 0x53, 0x52, 0x92, 0x96, 0x56, 0x57, 0x97,
    0x55, 0x95, 0x94, 0x54, 0x9C, 0x5C, 0x5D, 0x9D, 0x5F, 0x9F, 0x9E, 0x5E,
    0x5A, 0x9A, 0x9B, 0x5B, 0x99, 0x59, 0x58, 0x98, 0x88, 0x48, 0x49, 0x89,
    0x4B, 0x8B, 0x8A, 0x4A, 0x4E, 0x8E, 0x8F, 0x4F, 0x8D, 0x4D, 0x4C, 0x8C,
    0x44, 0x84, 0x85, 0x45, 0x87, 0x47, 0x46, 0x86, 0x82, 0x42, 0x43, 0x83,
    0x41, 0x81, 0x80, 0x40
};

uint16_t get_transaction_id(uint8_t *tcp_data) {
    return (uint16_t)((tcp_data[0] << 8) | tcp_data[1]);
}

uint16_t usMBCRC16(uint8_t *pucFrame, uint16_t usLen)
{
	uint8_t           ucCRCHi = 0xFF;
	uint8_t           ucCRCLo = 0xFF;
    int             iIndex;

    while( usLen-- )
    {
        iIndex = ucCRCLo ^ *( pucFrame++ );
        ucCRCLo = ( uint8_t )( ucCRCHi ^ aucCRCHi[iIndex] );
        ucCRCHi = aucCRCLo[iIndex];
    }
    return ( uint16_t )( ucCRCHi << 8 | ucCRCLo );
}

// Функция для расчета CRC16 (для ModbusRTU)
uint16_t calculate_crc16(uint8_t *buffer, int length) {
    uint16_t crc = 0xFFFF;

    for (int pos = 0; pos < length; pos++) {
        crc ^= (uint16_t)buffer[pos];

        for (int i = 8; i != 0; i--) {
            if ((crc & 0x0001) != 0) {
                crc >>= 1;
                crc ^= 0xA001;
            } else {
                crc >>= 1;
            }
        }
    }
    return crc;
}

// Функция проверки CRC для входящего RTU пакета
uint8_t verify_rtu_crc(uint8_t *rtu_data, int rtu_length) {
    if (rtu_length < 4) return false; // Минимальная длина RTU пакета

    // Получаем CRC из пакета (последние 2 байта)
    uint16_t received_crc = (rtu_data[rtu_length - 1] << 8) | rtu_data[rtu_length - 2];

    // Рассчитываем CRC для данных (без CRC)
    uint16_t calculated_crc = usMBCRC16(rtu_data, rtu_length - 2);

    return received_crc == calculated_crc;
}

// Функция преобразования из ModbusTCP в ModbusRTU
int tcp_to_rtu(uint8_t *tcp_data, int tcp_length, uint8_t *rtu_data, uint16_t *transaction_id) {
    if (tcp_length < 7) return -1; // Минимальная длина TCP пакета

    *transaction_id = get_transaction_id(tcp_data);

    //ModbusTCPHeader *header = (ModbusTCPHeader *)tcp_data;

    // Копируем данные без TCP заголовка
    int rtu_length = tcp_length - 6; // Убираем заголовок MBAP
    memcpy(rtu_data, tcp_data + 6, rtu_length);

    // Добавляем CRC в конец
    uint16_t crc = usMBCRC16(rtu_data, rtu_length);
    rtu_data[rtu_length] = crc & 0xFF;
    rtu_data[rtu_length + 1] = (crc >> 8) & 0xFF;

    return rtu_length + 2; // Длина + 2 байта CRC
}

// Функция преобразования из ModbusRTU в ModbusTCP
int rtu_to_tcp(uint8_t *rtu_data, int rtu_length, uint8_t *tcp_data, uint16_t transaction_id) {
    if (rtu_length < 4) {
        printf("Error: RTU packet too short\n");
        return -1;
    }

    // Проверяем CRC входящего пакета
    if (!verify_rtu_crc(rtu_data, rtu_length)) {
        printf("Error: RTU CRC check failed\n");
        return -2;
    }

    // Записываем MBAP заголовок по байтам для правильного порядка
    tcp_data[0] = (transaction_id >> 8) & 0xFF;    // Transaction ID High byte
    tcp_data[1] = transaction_id & 0xFF;           // Transaction ID Low byte
    tcp_data[2] = 0x00;                           // Protocol ID High byte
    tcp_data[3] = 0x00;                           // Protocol ID Low byte
    tcp_data[4] = ((rtu_length - 2) >> 8) & 0xFF; // Length High byte
    tcp_data[5] = (rtu_length - 2) & 0xFF;        // Length Low byte
    tcp_data[6] = rtu_data[0];                    // Unit ID

    // Копируем данные без CRC, начиная с 7-го байта TCP пакета
    memcpy(tcp_data + 7, rtu_data + 1, rtu_length - 3);

    return rtu_length + 4; // Длина RTU - 1 (UID)- 2 (CRC) + 7 (MBAP header)
}

// Вспомогательная функция для вывода содержимого пакета
void print_packet(uint8_t *data, int length, const char *prefix) {
    STM_LOG("%s (%d bytes):", prefix, length);
    for (int i = 0; i < length; i++) {
        if (i % 16 == 0) STM_LOG("\n");
        STM_LOG("%02X ", data[i]);
    }
    STM_LOG("\n");
}
