Sergey-V-Z/Ethernet_Power_Load_Controller/(commit log)

2023-08-14 Final Version from two projects
    [Bill of Materials-DriverPCB.xlsx, Bill of Materials-PWR_Switch_PCB.xlsx, Bill of Materials-control_PWR_PCB.xlsx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]
2023-08-30 Add funtion RS485
    Реализован ретранслятор из ethernet в rs485
    [control_PWR_PCB.PrjPcb]
2023-08-30 Doc
    Дополнение документации
    [lincks.xlsx]
2023-09-01 Auto stash before merge of "master" and "origin/master"
    [DriverPCB.SchDoc, PWR_Switch_PCB.SchDoc]
2023-09-06 doc update
    [Map Registers Control_LED.xlsx]
2023-09-28 update pin out
    [Bill of Materials-DriverPCB.xlsx, Bill of Materials-control_PWR_PCB.xlsx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]
2023-10-05 revers chanels led driver
    [main.c]
2023-10-24 modbus tcp
    [chanel.SchDoc]
2024-07-16 add funtion uart setings
    [DriverPCB.PrjPcb]
