Sergey-V-Z/Ethernet_Power_Load_Controller/(notices)

Notices in the files:
firmware/Contrrol/Control_PWR/Core/Inc/main.h:
Copyright (c) 2022 STMicroelectronics.
All rights reserved.
This software is licensed under terms that can be found in the LICENSE file
firmware/chanels_LED/chanels_led_drv/Core/Src/main.c:
Copyright (c) 2023 STMicroelectronics.
